Skynse/novakey/branding/novakey2.png

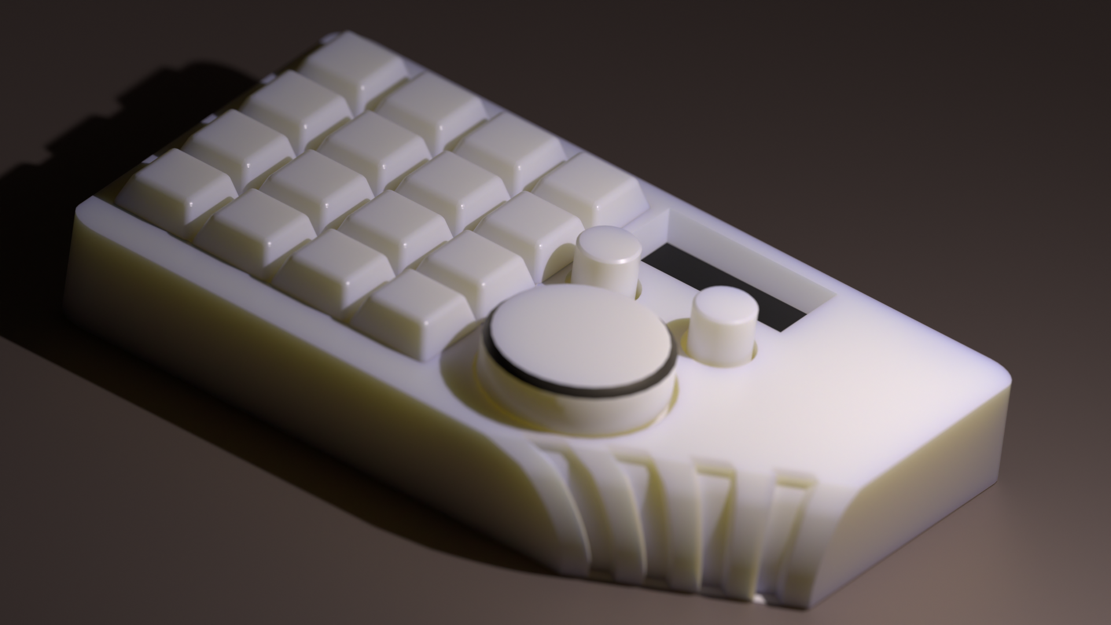
branding/novakey2.png
