Skynse/novakey/branding/novakey3.png

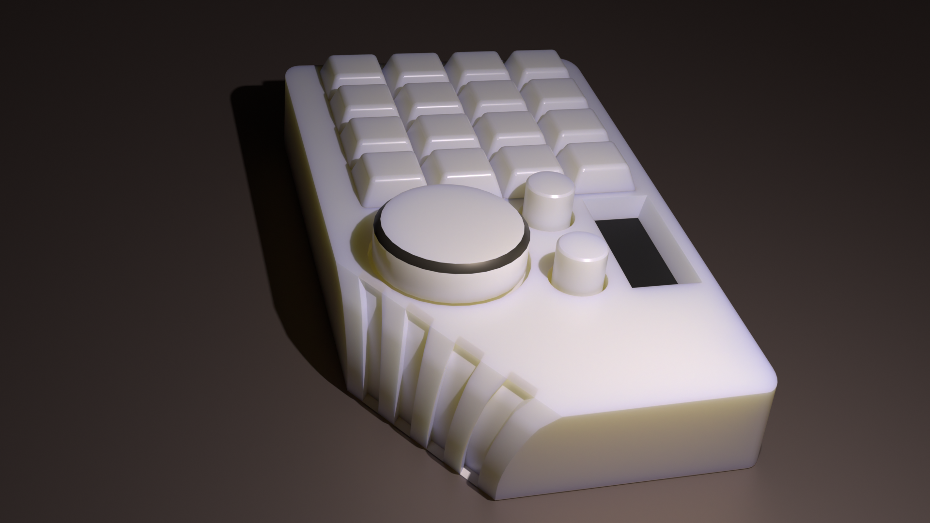
branding/novakey3.png
