Skynse/novakey/CAD/enclosure_v3/base_supports.png

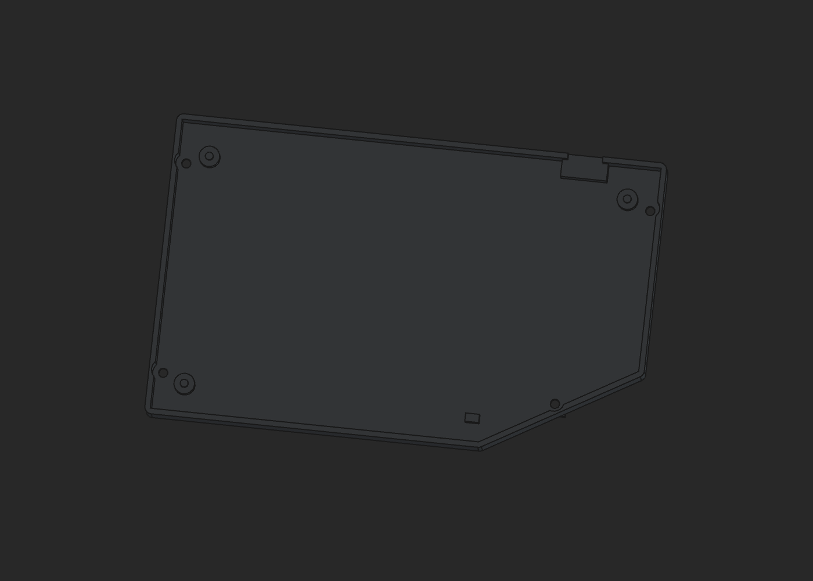
CAD/enclosure_v3/base_supports.png
