Skynse/novakey/CAD/enclosure_v3/flat_underside.png

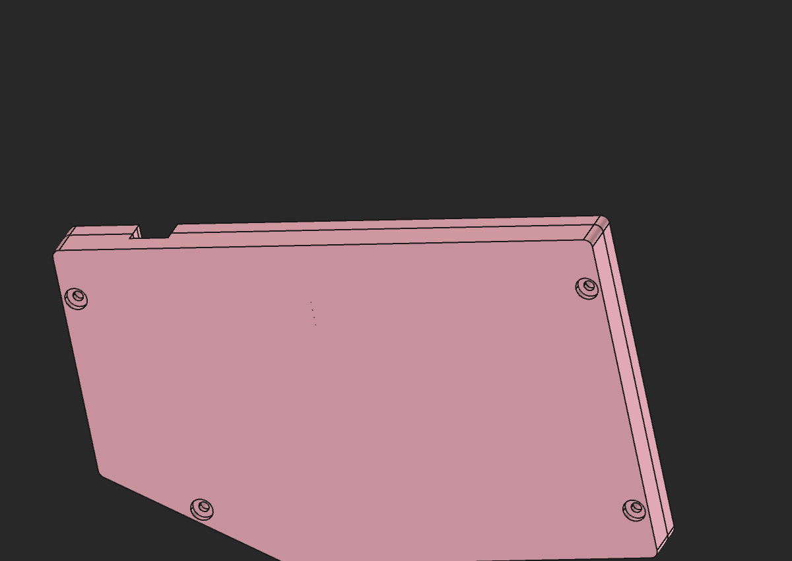
CAD/enclosure_v3/flat_underside.png
