Skynse/novakey/CAD/enclosure_v3/preview.png

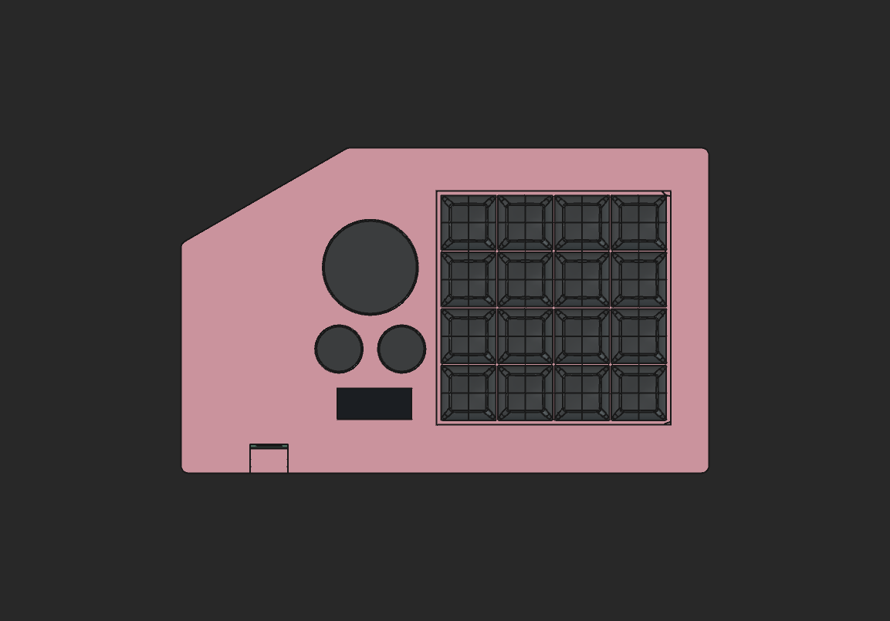
CAD/enclosure_v3/preview.png
