Skynse/novakey/CAD/enclosure_v3/upper_inside.png

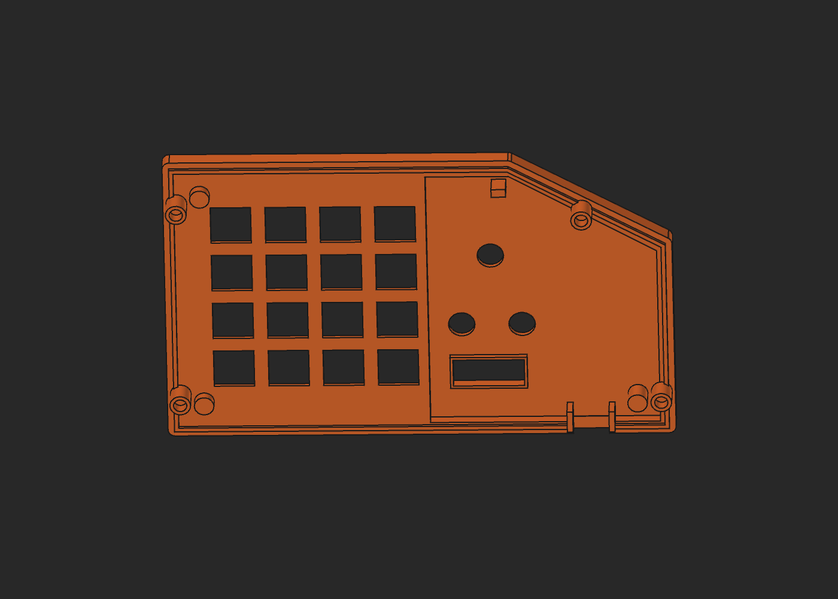
CAD/enclosure_v3/upper_inside.png
