Skynse/novakey/CAD/enclosure_v3/usb_tunnel.png

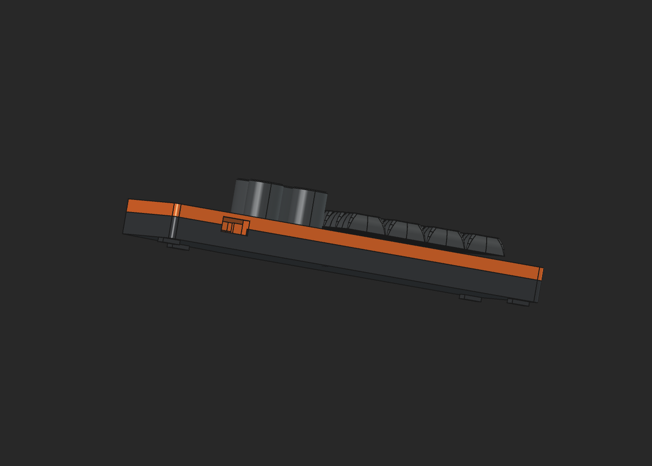
CAD/enclosure_v3/usb_tunnel.png
