Skynse/novakey/novakey_app/assets/novakey_v3.png

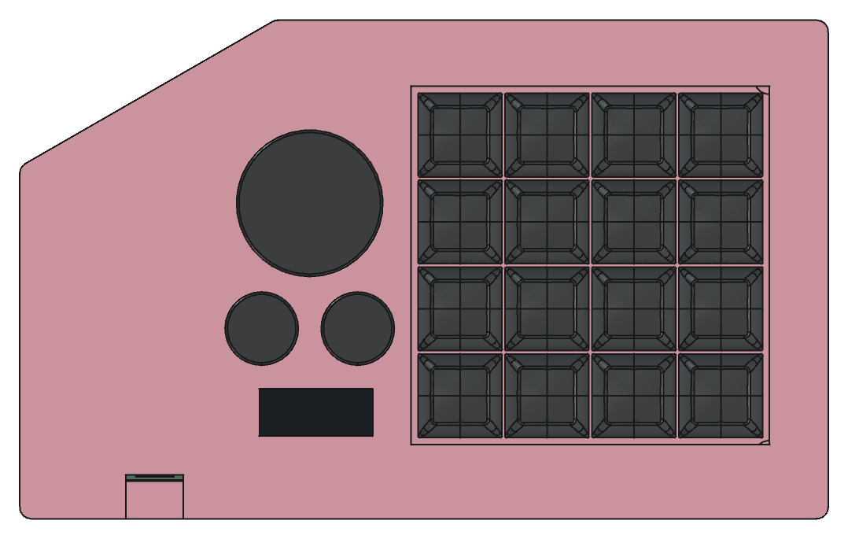
novakey_app/assets/novakey_v3.png
