Skynse/novakey/novakey_app/assets/novakey_v3_top_raw.png

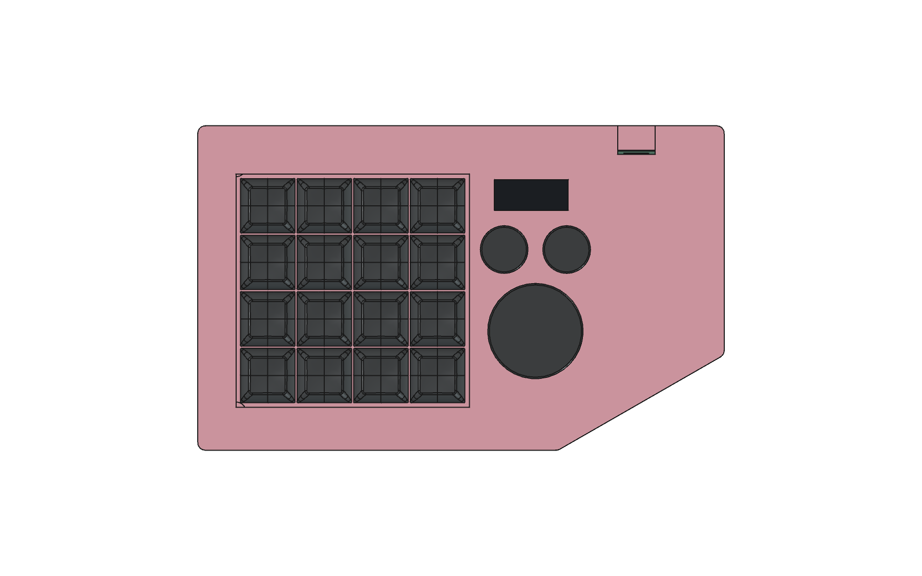
novakey_app/assets/novakey_v3_top_raw.png
