Skynse/novakey/CAD/enclosure_v3/NovaKey_V3.FCStd

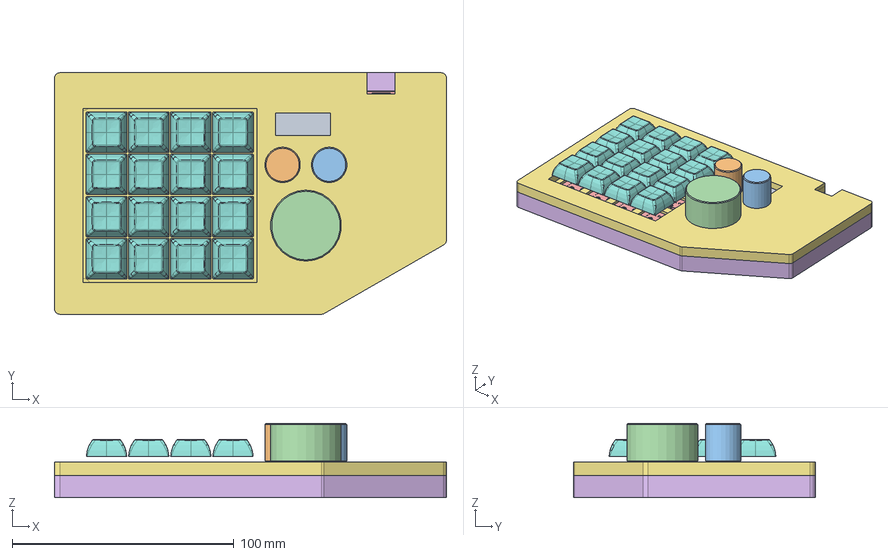
[picture p16: CAD file, 2026-09-28]
CAD/enclosure_v3/NovaKey_V3.FCStd
176.7 x 108.9 x 33.5 mm
SW_Hotswap_Kailh_cp
SW_Hotswap_Kailh_cp001
SW_Hotswap_Kailh_cp002
RaspberryPi_Pico_H_Module_KiCad
RaspberryPi_Pico_Header_DIP-40_H2.54mm_KiCad
SW_Hotswap_Kailh_cp003
SW_Hotswap_Kailh_cp004
SW_Hotswap_Kailh_cp005
SW_Hotswap_Kailh_cp006
SW_Hotswap_Kailh_cp007
SW_Hotswap_Kailh_cp008
SW_Hotswap_Kailh_cp009
SW_Hotswap_Kailh_cp010
SW_Hotswap_Kailh_cp011
SW_Hotswap_Kailh_cp012
SW_Hotswap_Kailh_cp013
SW_Hotswap_Kailh_cp014
SW_Hotswap_Kailh_cp015
D_DO-35_SOD27_P7.62mm_Horizontal
D_DO-35_SOD27_P7.62mm_Horizontal002
D_DO-35_SOD27_P7.62mm_Horizontal004
D_DO-35_SOD27_P7.62mm_Horizontal006
D_DO-35_SOD27_P7.62mm_Horizontal008
D_DO-35_SOD27_P7.62mm_Horizontal010
D_DO-35_SOD27_P7.62mm_Horizontal012
D_DO-35_SOD27_P7.62mm_Horizontal014
D_DO-35_SOD27_P7.62mm_Horizontal016
D_DO-35_SOD27_P7.62mm_Horizontal018
D_DO-35_SOD27_P7.62mm_Horizontal020
D_DO-35_SOD27_P7.62mm_Horizontal022
D_DO-35_SOD27_P7.62mm_Horizontal024
D_DO-35_SOD27_P7.62mm_Horizontal026
D_DO-35_SOD27_P7.62mm_Horizontal028
D_DO-35_SOD27_P7.62mm_Horizontal030
novakey_backup-unsaved-export-q46fwZ_silkscreen
novakey_backup-unsaved-export-q46fwZ_silkscreen001
novakey_backup-unsaved-export-q46fwZ_PCB
V3 • low-profile base
V3 • opaque upper shell and switch plate
Keycaps • imported reference
OLED • imported assembly reference
Knob 1 • imported STEP reference
Knob 2 • imported STEP reference
Knob 3 • imported STEP reference
