Skynse/novakey/CAD/Knob.FCStd

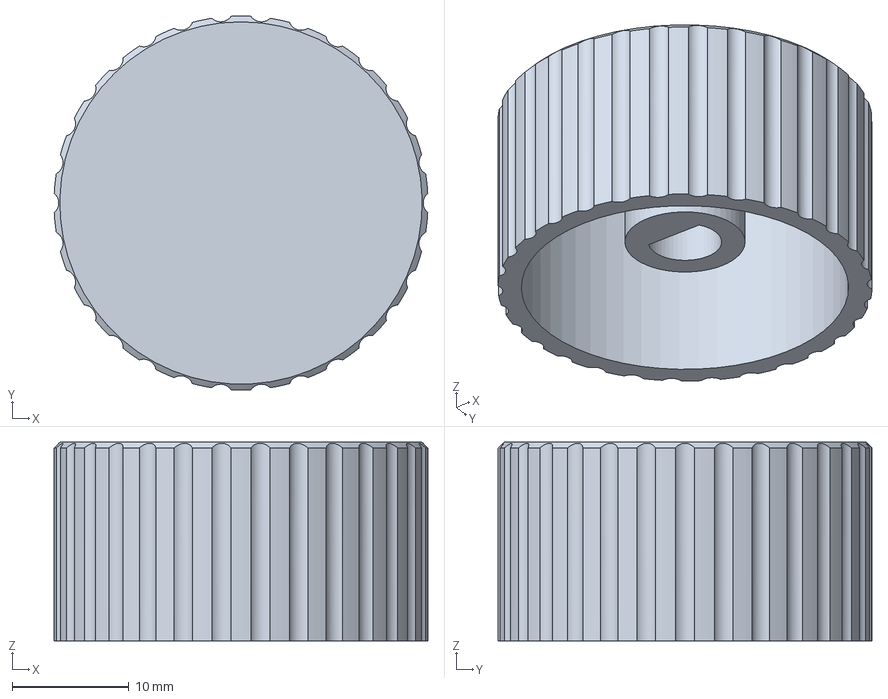
[picture p17: CAD file, 2026-09-28]
CAD/Knob.FCStd
32.0 x 32.0 x 17.0 mm
