Skynse/novakey/STEP/novakey.step

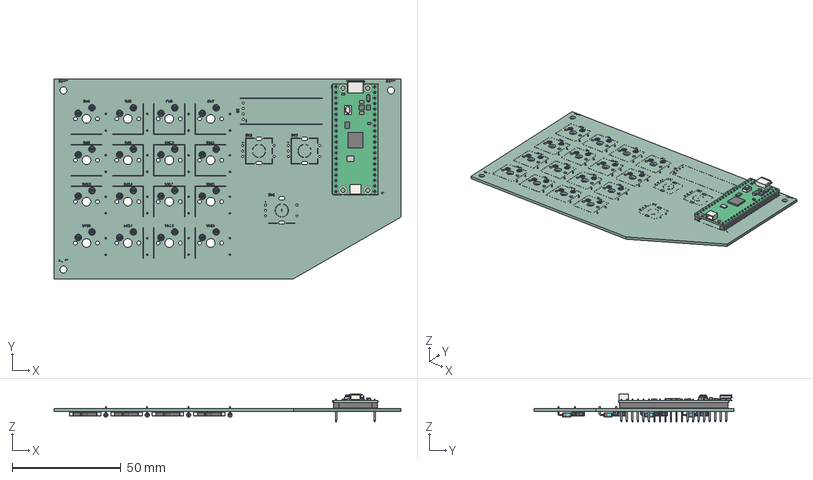
[picture p18: CAD file, 2026-09-27]
STEP/novakey.step
159.7 x 91.9 x 12.8 mm
SW_Hotswap_Kailh_cp x 16
RaspberryPi_Pico_H_Module_KiCad
RaspberryPi_Pico_Header_DIP-40_H2.54mm_KiCad
D_DO-35_SOD27_P7.62mm_Horizontal x 16
novakey_backup-unsaved-export-q46fwZ_silkscreen x 2
novakey_backup-unsaved-export-q46fwZ_PCB
