Skynse/novakey/CAD/enclosure_v3/Base_flat.stl

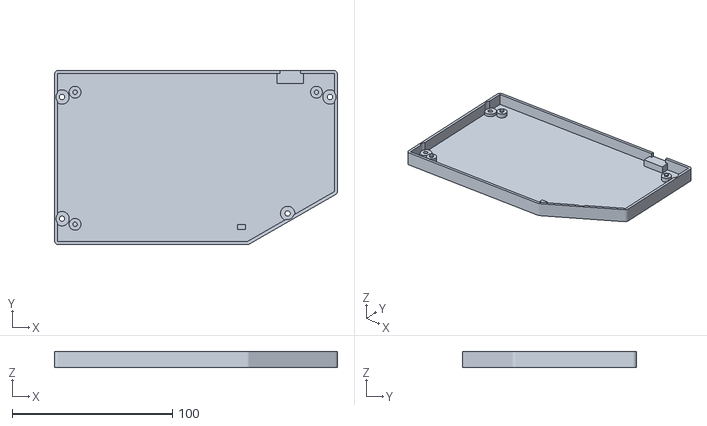
[picture p19: CAD file, 2026-09-27]
CAD/enclosure_v3/Base_flat.stl
176.7 x 108.9 x 10.0
