Skynse/novakey/CAD/STEP/knob-small.step

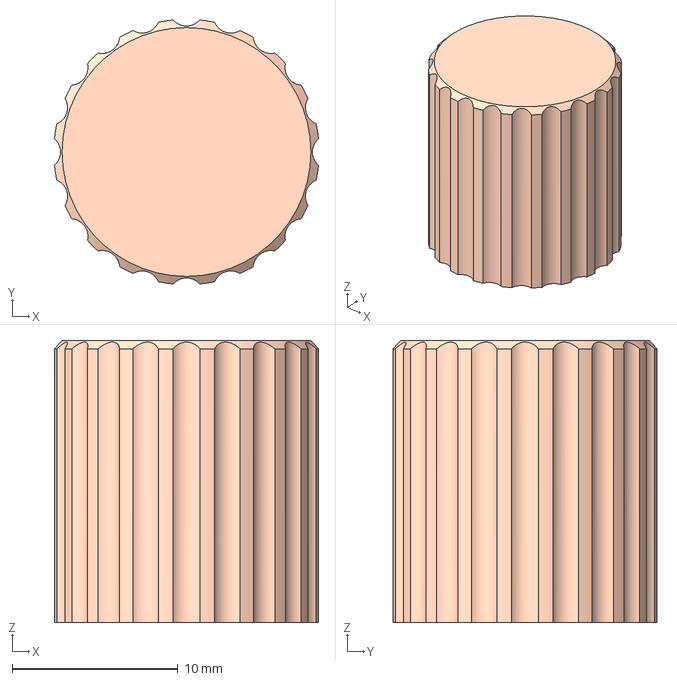
[picture p20: CAD file, 2026-09-28]
CAD/STEP/knob-small.step
15.9 x 15.9 x 17.0 mm
