Skynse/novakey/CAD/enclosure_v3/Upper_flat_base.stl

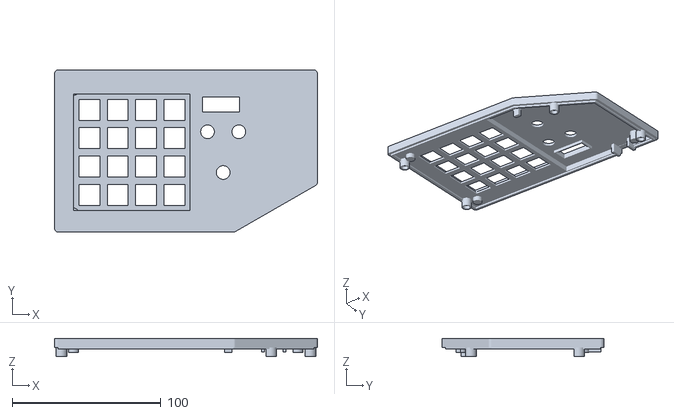
[picture p21: CAD file, 2026-09-27]
CAD/enclosure_v3/Upper_flat_base.stl
176.7 x 108.9 x 12.2
