Skynse/novakey/CAD/STEP/NovaKey_V3.step

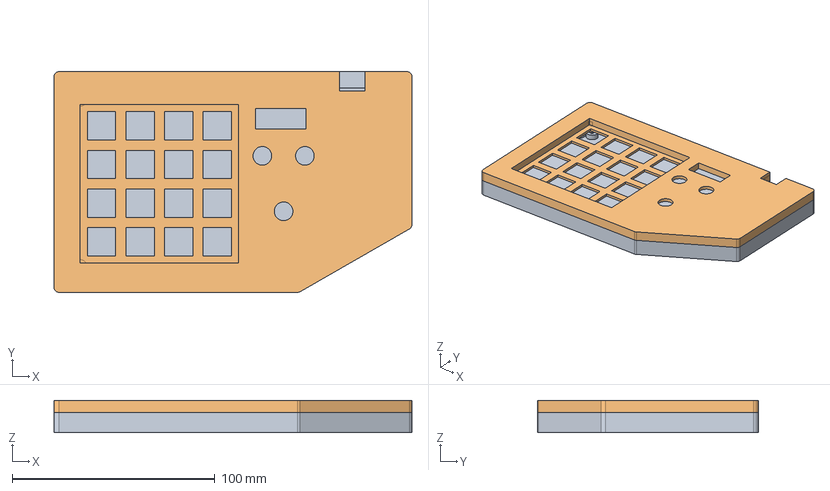
[picture p22: CAD file, 2026-09-27]
CAD/STEP/NovaKey_V3.step
176.7 x 108.9 x 16.0 mm
V3 • low-profile base
V3 • opaque upper shell and switch plate
