Skynse/novakey/(list of files, cad)

Other CAD files:
CAD/STEP/assembly.step
CAD/STEP/kob-large.step
CAD/STEP/assembly.stl
