Skynse/novakey/kicad_files/novakey_backup.kicad_pcb

## KiCad design kicad_files/novakey_backup.kicad_pcb (2026-09-27)

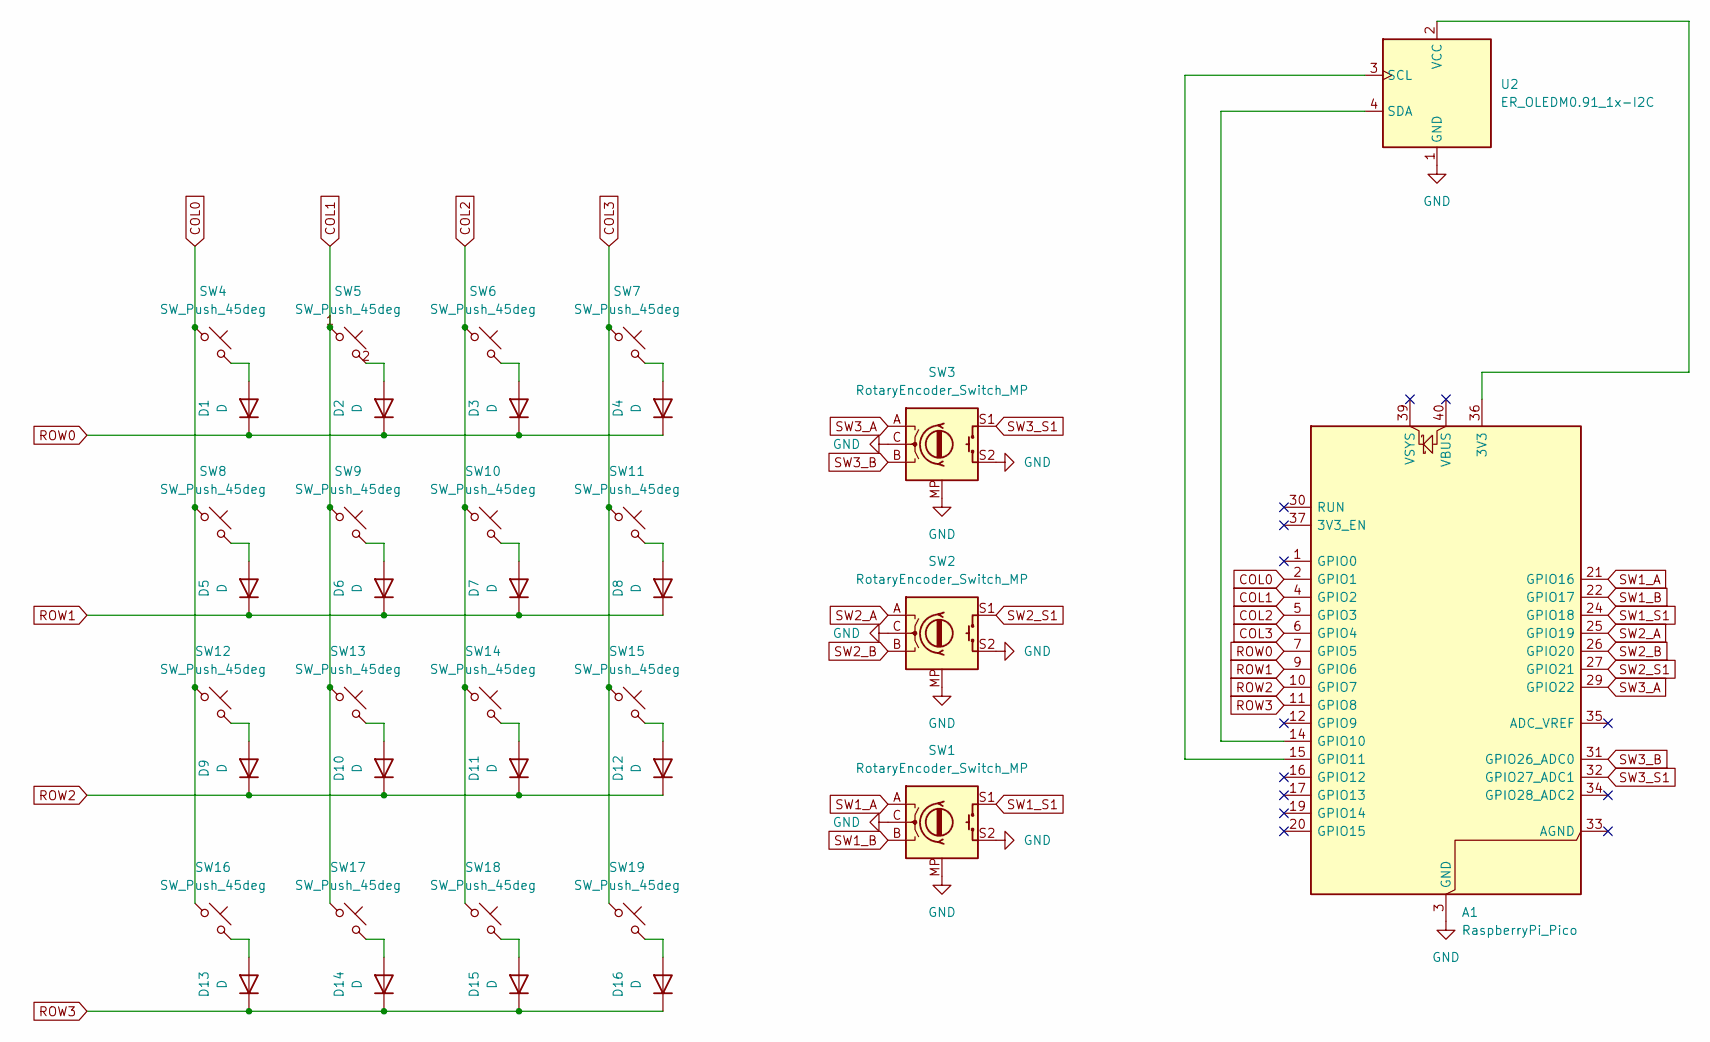
[picture p23: schematic novakey_backup.kicad_sch]

Parts:
A1: RaspberryPi_Pico; RaspberryPi_Pico_Common_THT
D1, D2, D3, D4, D5, D6, D7, D8, D9, D10, D11, D12, D13, D14, D15, D16: D; D_DO-35_SOD27_P7.62mm_Horizontal
SW1, SW2, SW3: RotaryEncoder_Switch_MP; RotaryEncoder_Alps_EC11E-Switch_Vertical_H20mm
SW4, SW5, SW6, SW7, SW8, SW9, SW10, SW11, SW12, SW13, SW14, SW15, SW16, SW17, SW18, SW19: SW_Push_45deg; SW_Hotswap_Kailh_MX_1.00u
U2: ER_OLEDM0.91_1x-I2C

Connections:
COL0: A1.2 (GPIO1), SW4.1, SW8.1, SW12.1, SW16.1
COL1: A1.4 (GPIO2), SW5.1, SW9.1, SW13.1, SW17.1
COL2: A1.5 (GPIO3), SW6.1, SW10.1, SW14.1, SW18.1
COL3: A1.6 (GPIO4), SW7.1, SW11.1, SW15.1, SW19.1
GND: A1.3 (GND), A1.8 (GND), A1.13 (GND), A1.18 (GND), A1.23 (GND), A1.28 (GND), A1.38 (GND), SW1.C, SW1.MP, SW1.S2, SW2.C, SW2.MP, SW2.S2, SW3.C, SW3.MP, SW3.S2, U2.1 (GND)
unnamed: A1.36 (3V3), U2.2 (VCC)
unnamed: A1.14 (GPIO10), U2.4 (SDA)
unnamed: A1.15 (GPIO11), U2.3 (SCL)
unnamed: D1.2 (A), SW4.2
unnamed: D2.2 (A), SW5.2
unnamed: D3.2 (A), SW6.2
unnamed: D4.2 (A), SW7.2
unnamed: D5.2 (A), SW8.2
unnamed: D6.2 (A), SW9.2
unnamed: D7.2 (A), SW10.2
unnamed: D8.2 (A), SW11.2
unnamed: D9.2 (A), SW12.2
unnamed: D10.2 (A), SW13.2
unnamed: D11.2 (A), SW14.2
unnamed: D12.2 (A), SW15.2
unnamed: D13.2 (A), SW16.2
unnamed: D14.2 (A), SW17.2
unnamed: D15.2 (A), SW18.2
unnamed: D16.2 (A), SW19.2
ROW0: A1.7 (GPIO5), D1.1 (K), D2.1 (K), D3.1 (K), D4.1 (K)
ROW1: A1.9 (GPIO6), D5.1 (K), D6.1 (K), D7.1 (K), D8.1 (K)
ROW2: A1.10 (GPIO7), D9.1 (K), D10.1 (K), D11.1 (K), D12.1 (K)
ROW3: A1.11 (GPIO8), D13.1 (K), D14.1 (K), D15.1 (K), D16.1 (K)
SW1_A: A1.21 (GPIO16), SW1.A
SW1_B: A1.22 (GPIO17), SW1.B
SW1_S1: A1.24 (GPIO18), SW1.S1
SW2_A: A1.25 (GPIO19), SW2.A
SW2_B: A1.26 (GPIO20), SW2.B
SW2_S1: A1.27 (GPIO21), SW2.S1
SW3_A: A1.29 (GPIO22), SW3.A
SW3_B: A1.31 (GPIO26_ADC0), SW3.B
SW3_S1: A1.32 (GPIO27_ADC1), SW3.S1

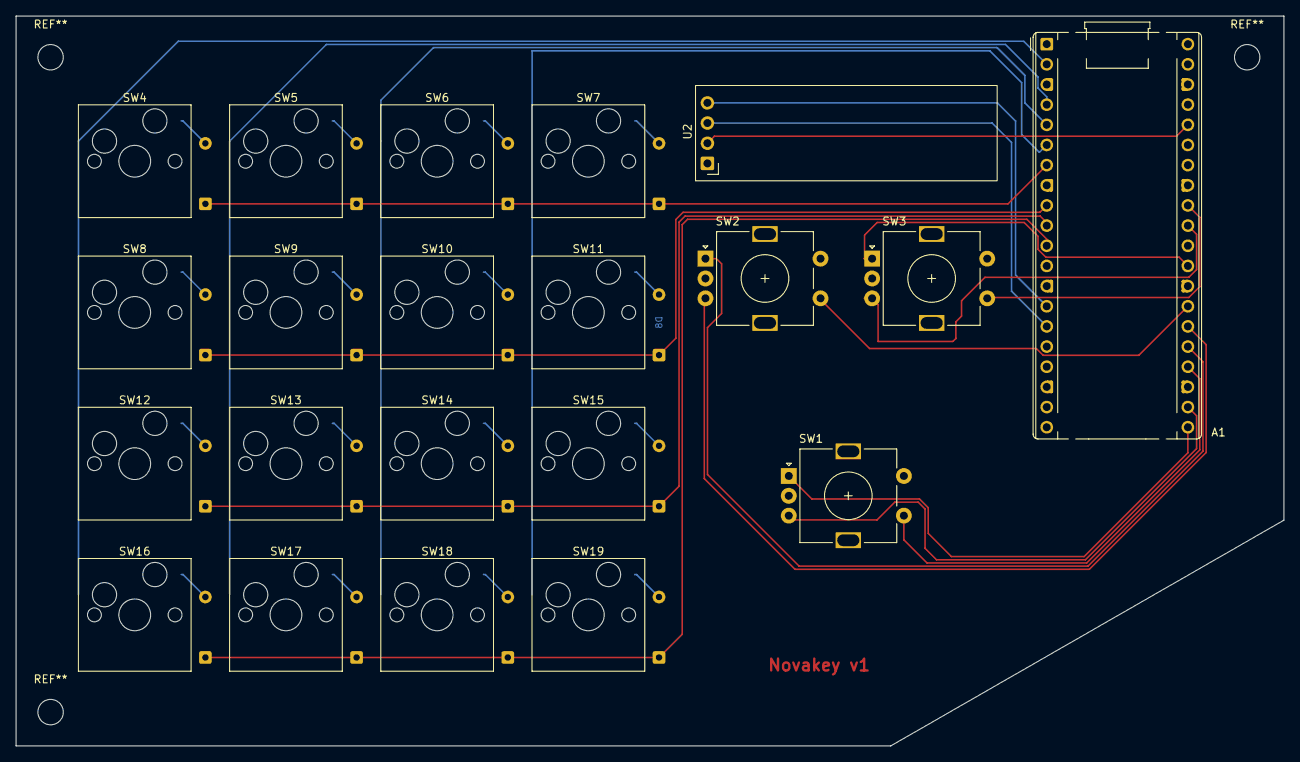
[picture p24: board novakey_backup.kicad_pcb from above]

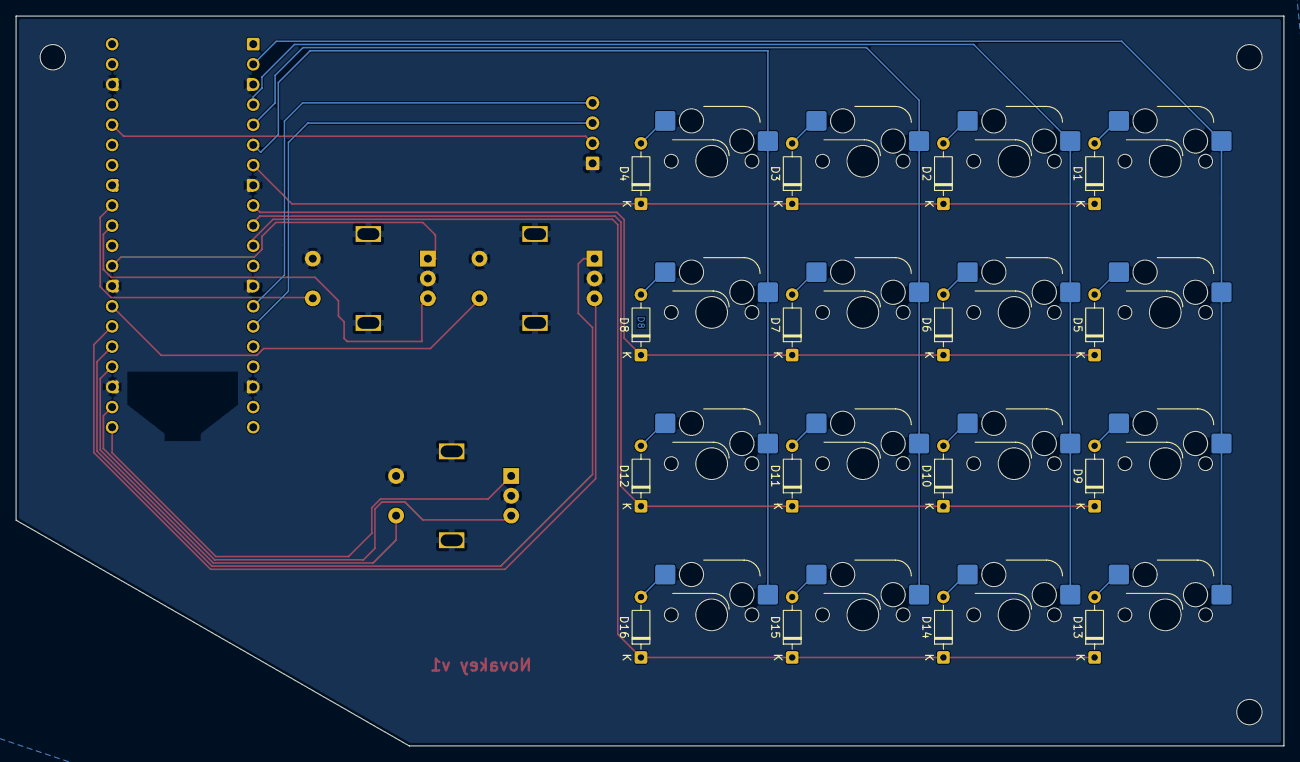
[picture p25: board novakey_backup.kicad_pcb from below]

Board: 2 copper layers, 159.7 x 91.9 mm, 37 parts (16 on the bottom side), 37 nets.
