Skynse/novakey/(commit log)

2026-09-28 update app UI
    [Knob.FCStd, NovaKey_V3.FCStd, knob-small.step, kob-large.step]
2026-09-28 require 4 transitions per step to register encoder turn
2026-09-28 add bindings HUD
    [Knob.FCStd]
2026-10-24 add bom
